nielsssssss/htbluva_sbg_e_moped/Webstack/img/80kmh.png

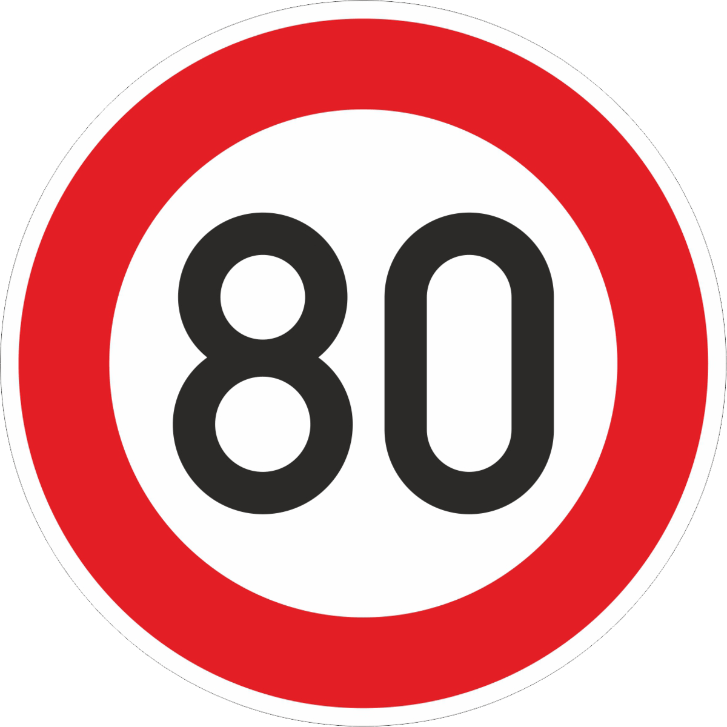
Webstack/img/80kmh.png
