nielsssssss/htbluva_sbg_e_moped/Webstack/img/bg.jpg

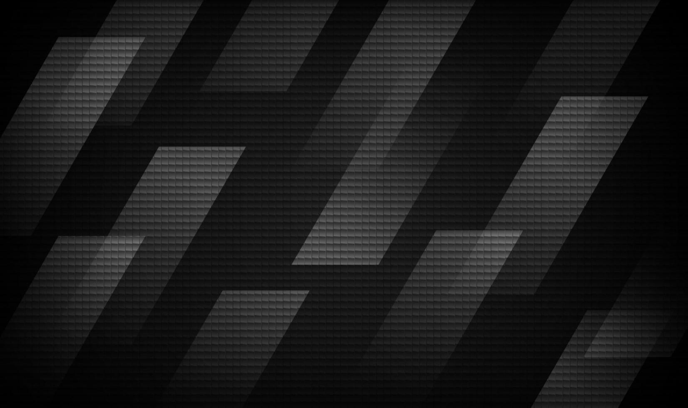
Webstack/img/bg.jpg
