nielsssssss/htbluva_sbg_e_moped/Webstack/img/blinker.png

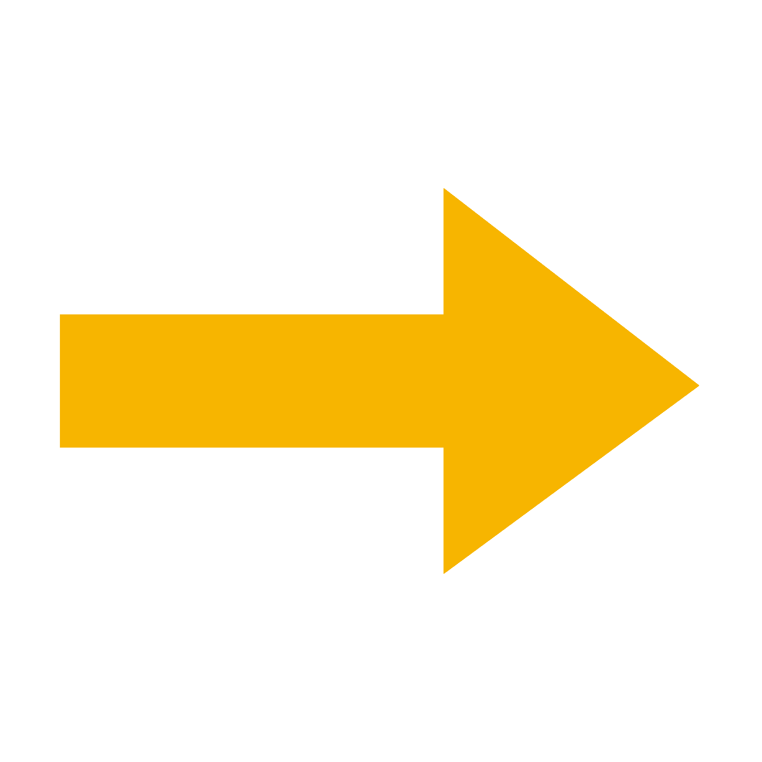
Webstack/img/blinker.png
