nielsssssss/htbluva_sbg_e_moped/Webstack/img/overtake.png

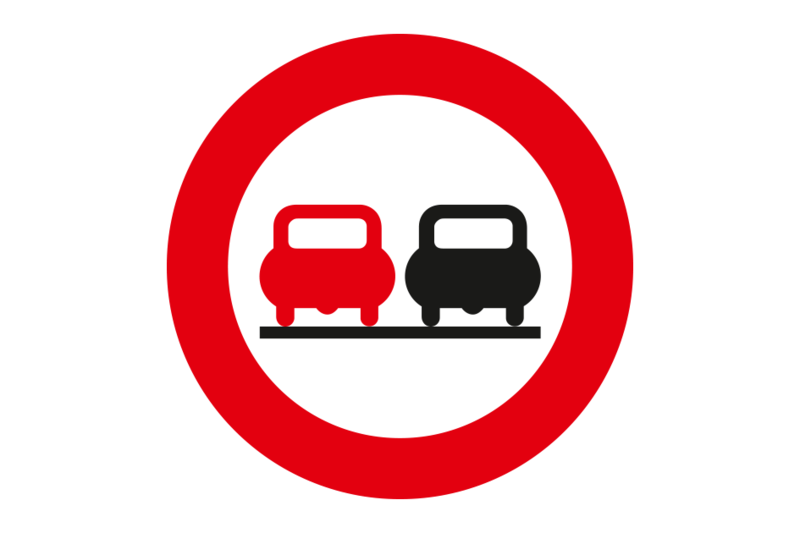
Webstack/img/overtake.png
