nielsssssss/htbluva_sbg_e_moped/Webstack/img/settings/bg.jpeg

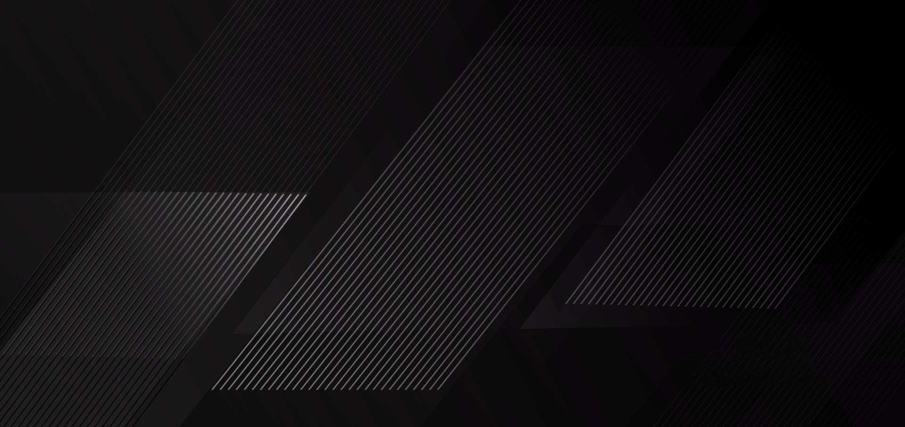
Webstack/img/settings/bg.jpeg
